machdyne/katze/pcb/katze_v1.pdf

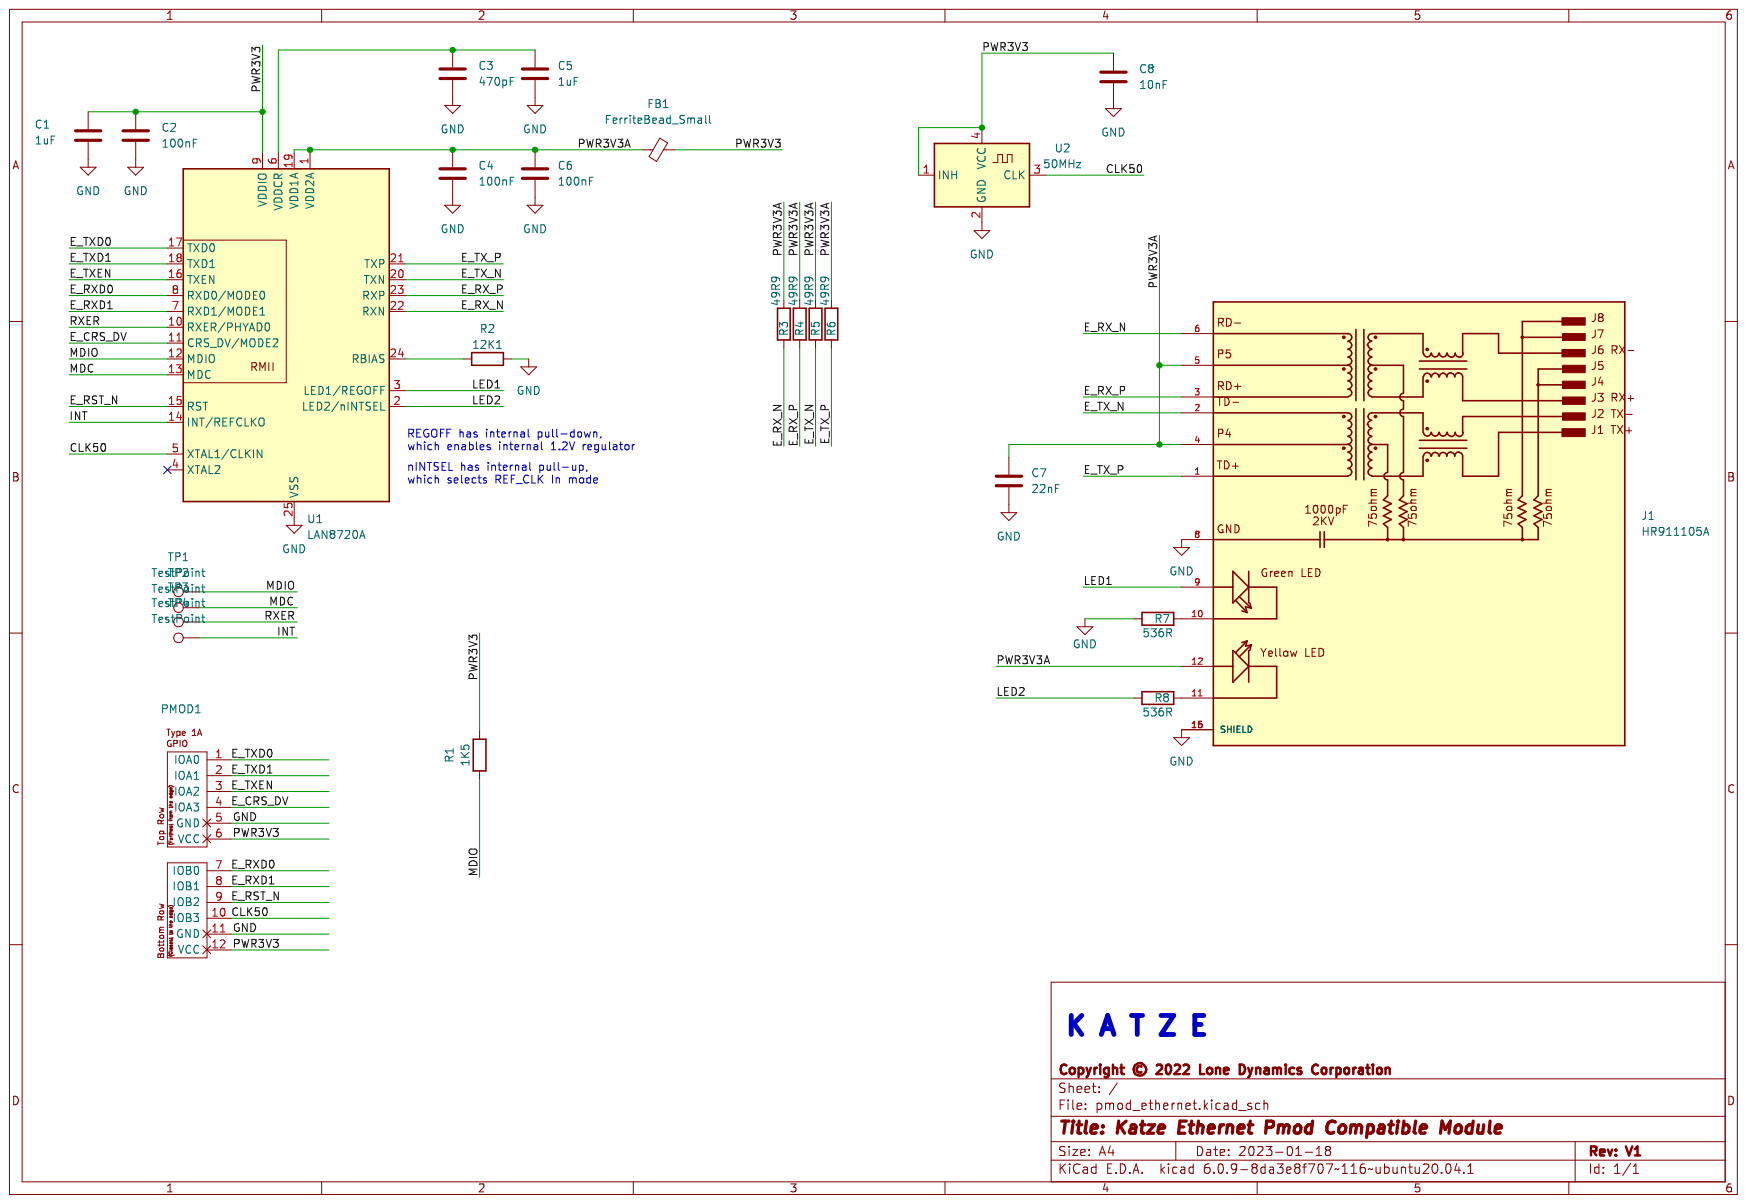
[picture p2: page 1]
