machdyne/katze/pcb/katze_v0.pdf

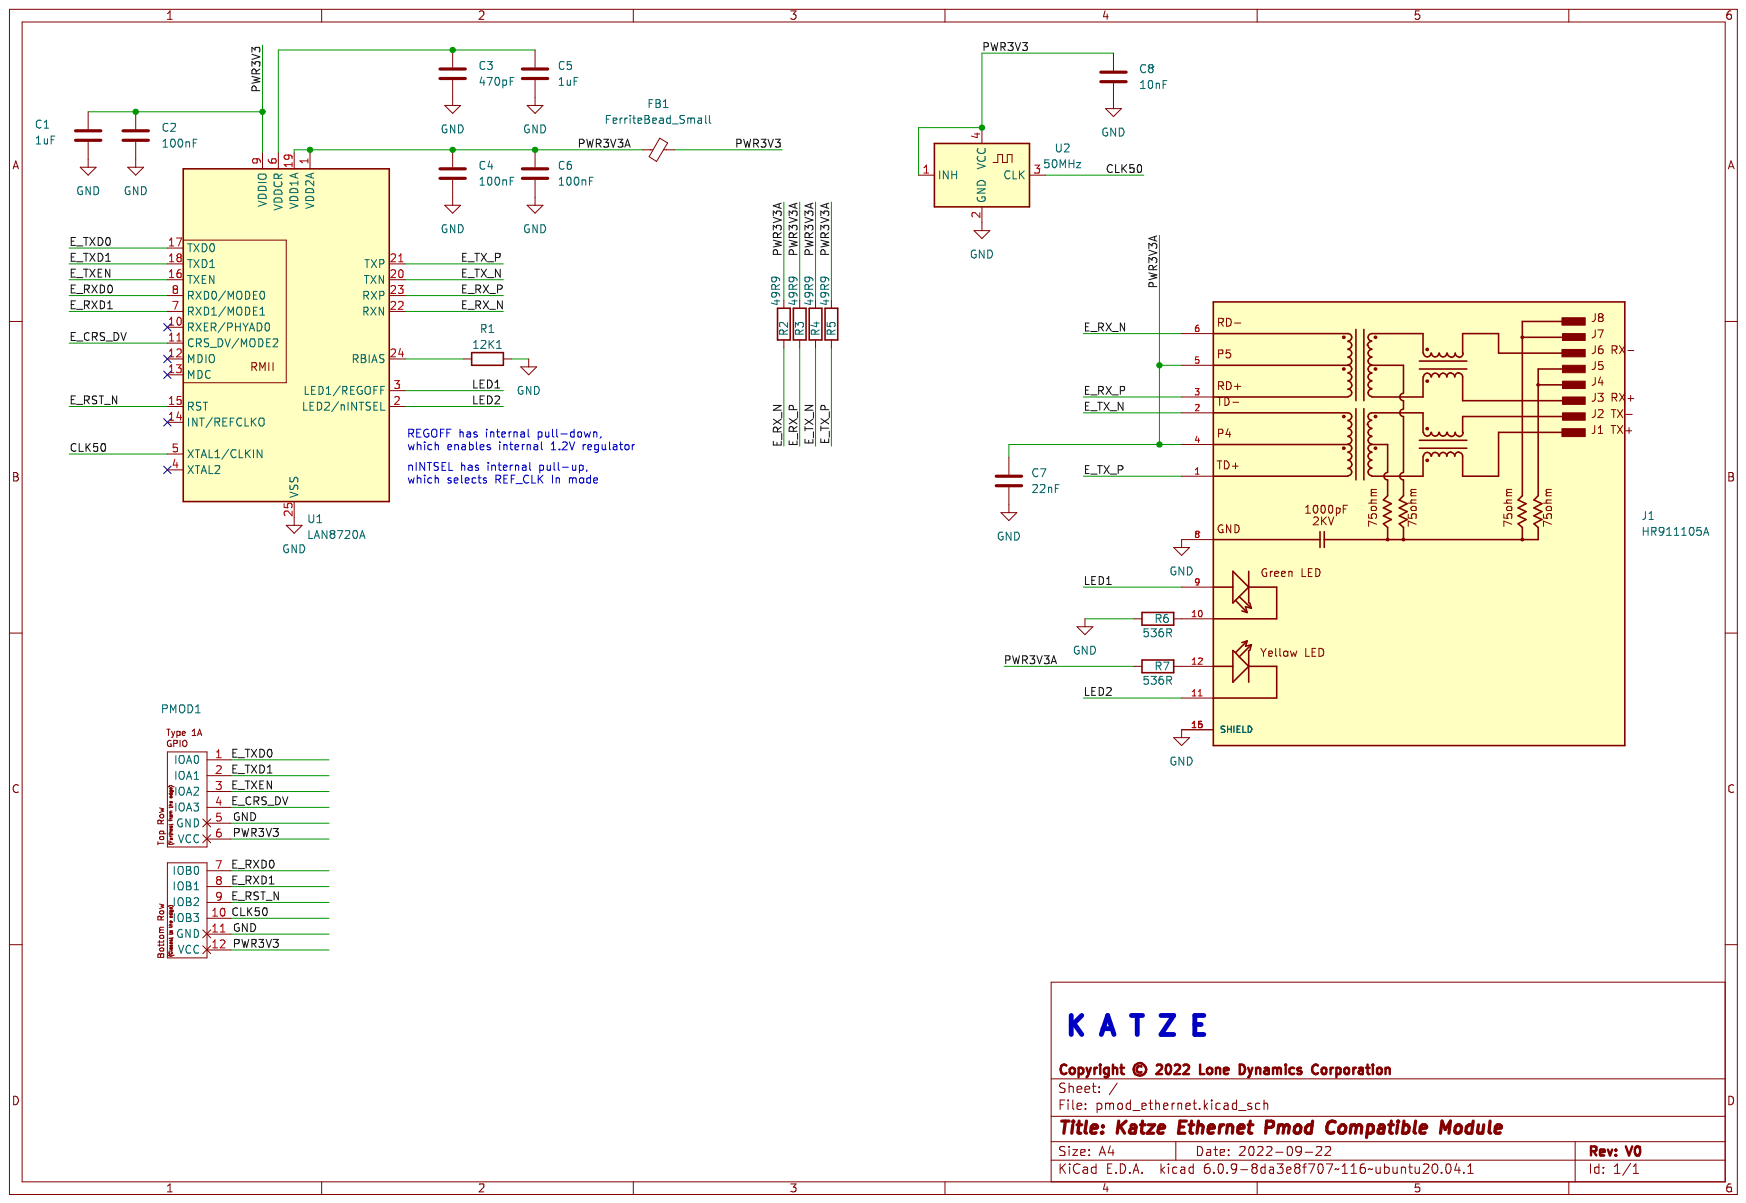
[picture p3: page 1]
