machdyne/katze/pcb/katze_v1/pmod_ethernet.kicad_pcb

## KiCad design pcb/katze_v1/pmod_ethernet.kicad_pcb (2026-07-26)

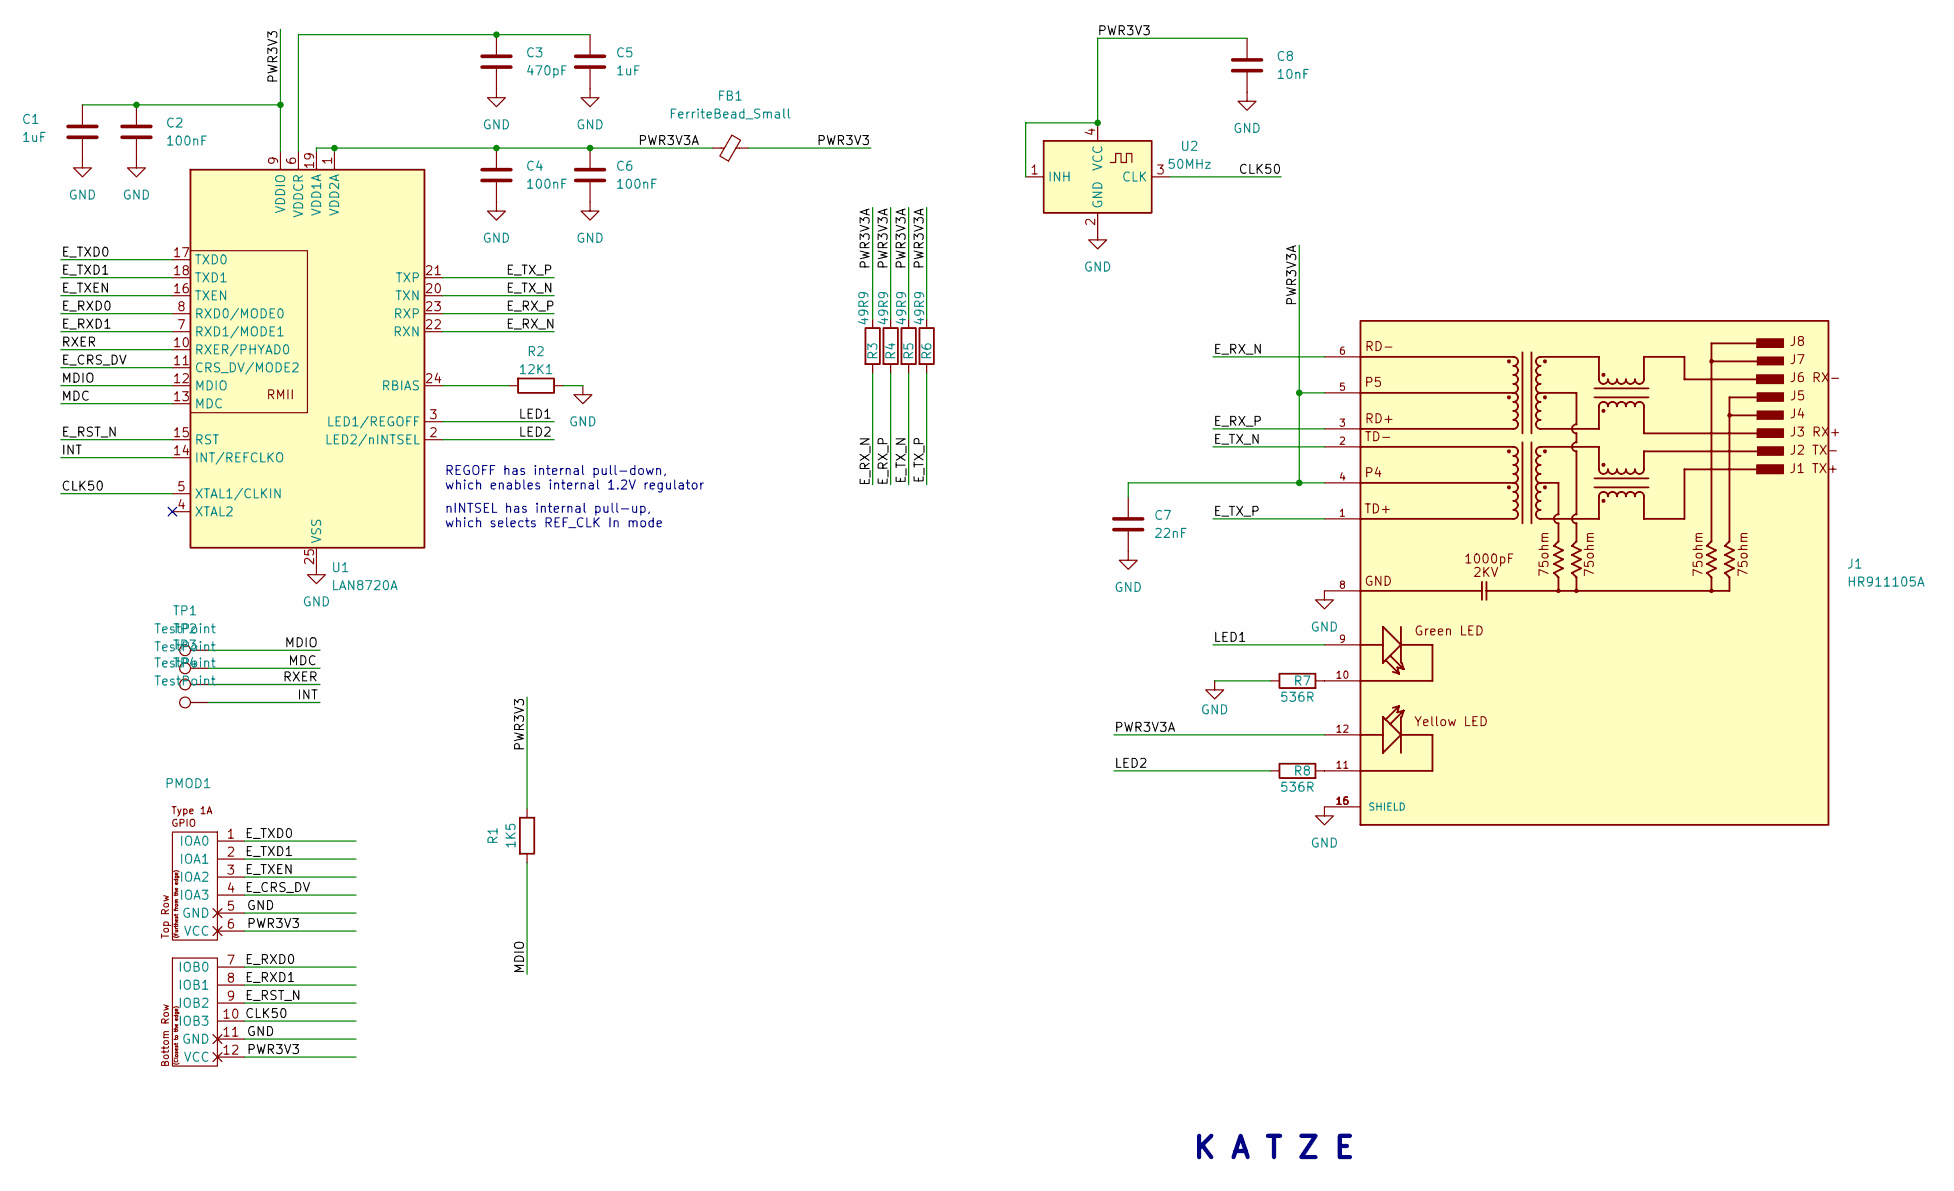
[picture p4: schematic pmod_ethernet.kicad_sch, Katze Ethernet Pmod Compatible Module]

Parts:
C1, C5: 1uF; C_0402_1005Metric
C2, C4, C6: 100nF; C_0402_1005Metric
C3: 470pF; C_0603_1608Metric
C7: 22nF; C_0603_1608Metric
C8: 10nF; R_0402_1005Metric
FB1: FerriteBead_Small; R_0402_1005Metric
J1: HR911105A; HANRUN_HR911105A; PARTREV A
PMOD1: PMOD-Device-x2-Type-1A-GPIO; pmod_pin_array_6x2
R1: 1K5; R_0402_1005Metric
R2: 12K1; R_0603_1608Metric
R3, R4, R5, R6: 49R9; R_0603_1608Metric
R7, R8: 536R; R_0402_1005Metric
TP1, TP2, TP3, TP4: TestPoint; TestPoint_Pad_1.0x1.0mm
U1: LAN8720A; QFN-24-1EP_4x4mm_P0.5mm_EP2.6x2.6mm
U2: 50MHz; Oscillator_SMD_Kyocera_KC2520Z-4Pin_2.5x2.0mm

Connections:
/CLK50: PMOD1.10 (IOB3), U1.5 (XTAL1/CLKIN), U2.3 (CLK)
/E_CRS_DV: PMOD1.4 (IOA3), U1.11 (CRS_DV/MODE2)
/E_RST_N: PMOD1.9 (IOB2), U1.15 (RST)
/E_RXD0: PMOD1.7 (IOB0), U1.8 (RXD0/MODE0)
/E_RXD1: PMOD1.8 (IOB1), U1.7 (RXD1/MODE1)
/E_RX_N: J1.6, R3.2, U1.22 (RXN)
/E_RX_P: J1.3, R4.2, U1.23 (RXP)
/E_TXD0: PMOD1.1 (IOA0), U1.17 (TXD0)
/E_TXD1: PMOD1.2 (IOA1), U1.18 (TXD1)
/E_TXEN: PMOD1.3 (IOA2), U1.16 (TXEN)
/E_TX_N: J1.2, R5.2, U1.20 (TXN)
/E_TX_P: J1.1, R6.2, U1.21 (TXP)
/INT: TP4.1, U1.14 (INT/REFCLKO)
/LED1: J1.9, U1.3 (LED1/REGOFF)
/LED2: R8.1, U1.2 (LED2/nINTSEL)
/MDC: TP2.1, U1.13 (MDC)
/MDIO: R1.2, TP1.1, U1.12 (MDIO)
/PWR3V3: C1.1, C2.1, C8.1, FB1.2, PMOD1.6 (VCC), PMOD1.12 (VCC), R1.1, U1.9 (VDDIO), U2.1 (INH), U2.4 (VCC)
/PWR3V3A: C4.1, C6.1, C7.1, FB1.1, J1.4, J1.5, J1.12, R3.1, R4.1, R5.1, R6.1, U1.1 (VDD2A), U1.19 (VDD1A)
/RXER: TP3.1, U1.10 (RXER/PHYAD0)
GND: C1.2, C2.2, C3.2, C4.2, C5.2, C6.2, C7.2, C8.2, J1.8, J1.15 (SHIELD), J1.16 (SHIELD), PMOD1.5 (GND), PMOD1.11 (GND), R2.1, R7.1, U1.25 (VSS), U2.2 (GND)
unnamed: C3.1, C5.1, U1.6 (VDDCR)
unnamed: J1.10, R7.2
unnamed: J1.11, R8.2
unnamed: R2.2, U1.24 (RBIAS)

Notes on the sheet:
nINTSEL has internal pull-up, which selects REF_CLK In mode
REGOFF has internal pull-down, which enables internal 1.2V regulator
K A T Z E

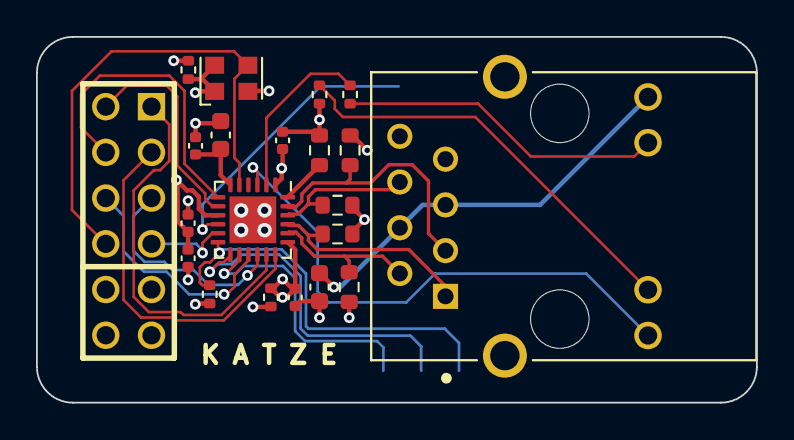
[picture p5: board pmod_ethernet.kicad_pcb from above]

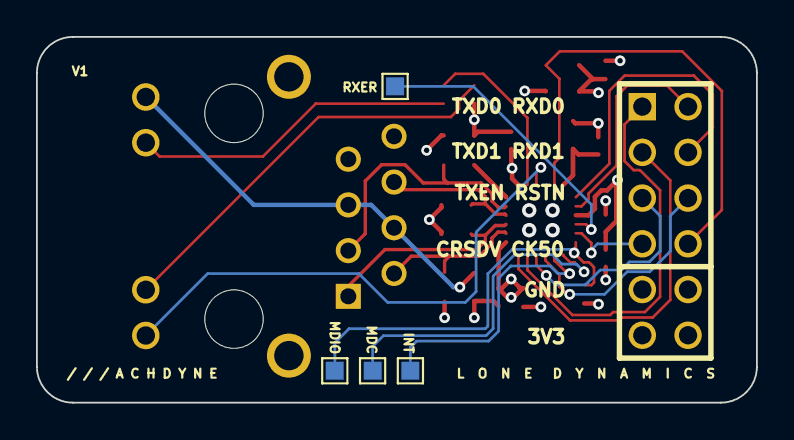
[picture p6: board pmod_ethernet.kicad_pcb from below]

Board: 4 copper layers, 40.0 x 20.3 mm, 25 parts (4 on the bottom side), 25 nets.
