machdyne/katze/(threads)

Thread 1 (2023-02-22):

allow external clock input by optionally disabling oscillator

ozel, 2023-02-22:
Hi, I like the Katze pmod, it's nice and compact!

Could you consider adding a solder jumper (maybe by default closed with a tiny trace) after the oscillator output such that the clock can be optionally provided by the FPGA itself? There are a few solder jumper footprints in KiCAD.

An external clock is useful when the number of clock input-capable pins is limited on some boards but spare PLL outputs are available and can be more freely assigned to IOs. I am currently running a modified Waveshare board in external clock mode, it seems fine so far.

machdyne, 2023-03-02:
Thanks. I will definitely plan this for the next revision, and might even be able to fit a removable jumper somewhere. In the meantime if anyone really needs to do this it should be possible by removing the oscillator.
