machdyne/katze/(commit log)

2023-02-01 update schematics
2026-07-26 add pcb layout
