machdyne/katze/(notices)

Notices in the files:
pcb/katze_v1/pmod_ethernet.kicad_sch:
Copyright © 2022 Lone Dynamics Corporation
